vheathen/midal/hardware/pics/perfboard-03.png

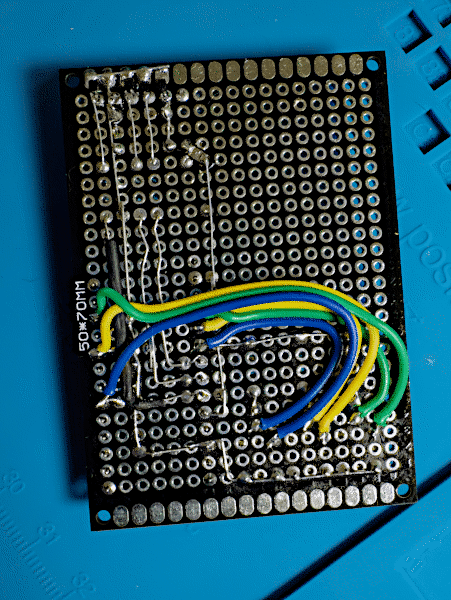
hardware/pics/perfboard-03.png
