vheathen/midal/hardware/pdf/Core board/SCH_Core board_2-PEDAL.pdf

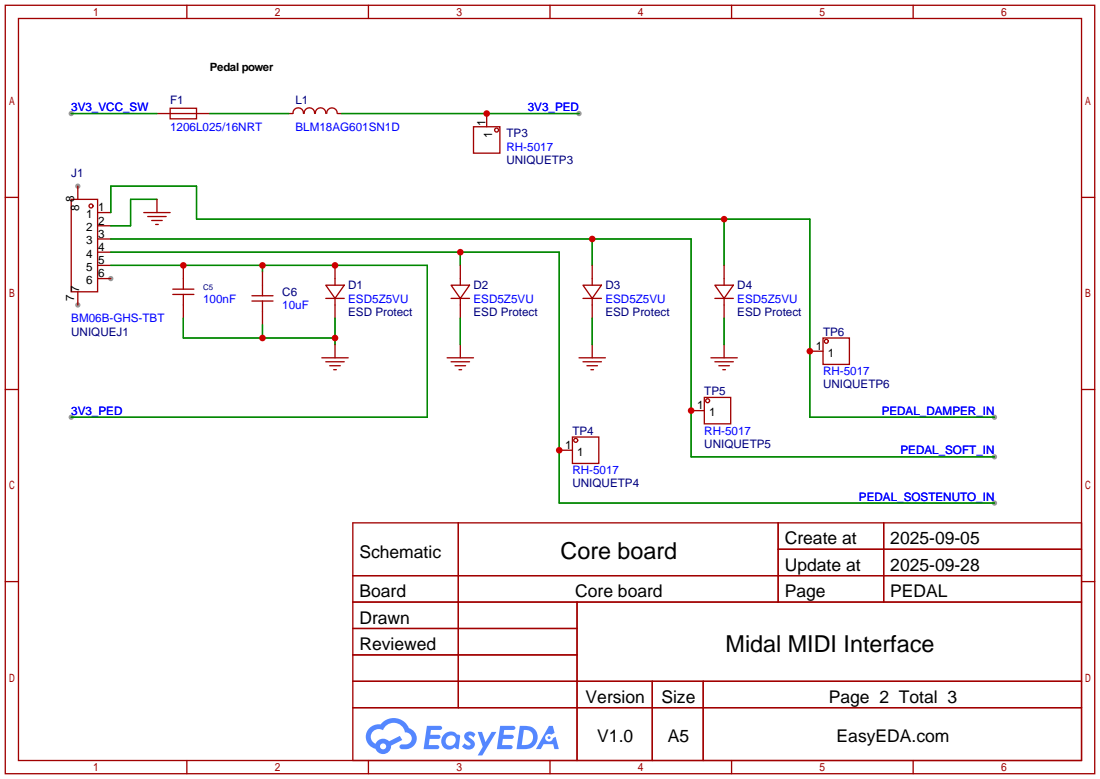
[picture p7: page 1]

Schematic | Core board | Create at | 2025-09-05

Update at | 2025-09-28

Board | Core board | Page | PEDAL
Drawn | | Midal MIDI Interface
Reviewed

Version | Size | Page 2 Total 3
V1.0 | A5 | EasyEDA.com
