vheathen/midal/hardware/pdf/Core board/SCH_Core board_3-MIDI OUT.pdf

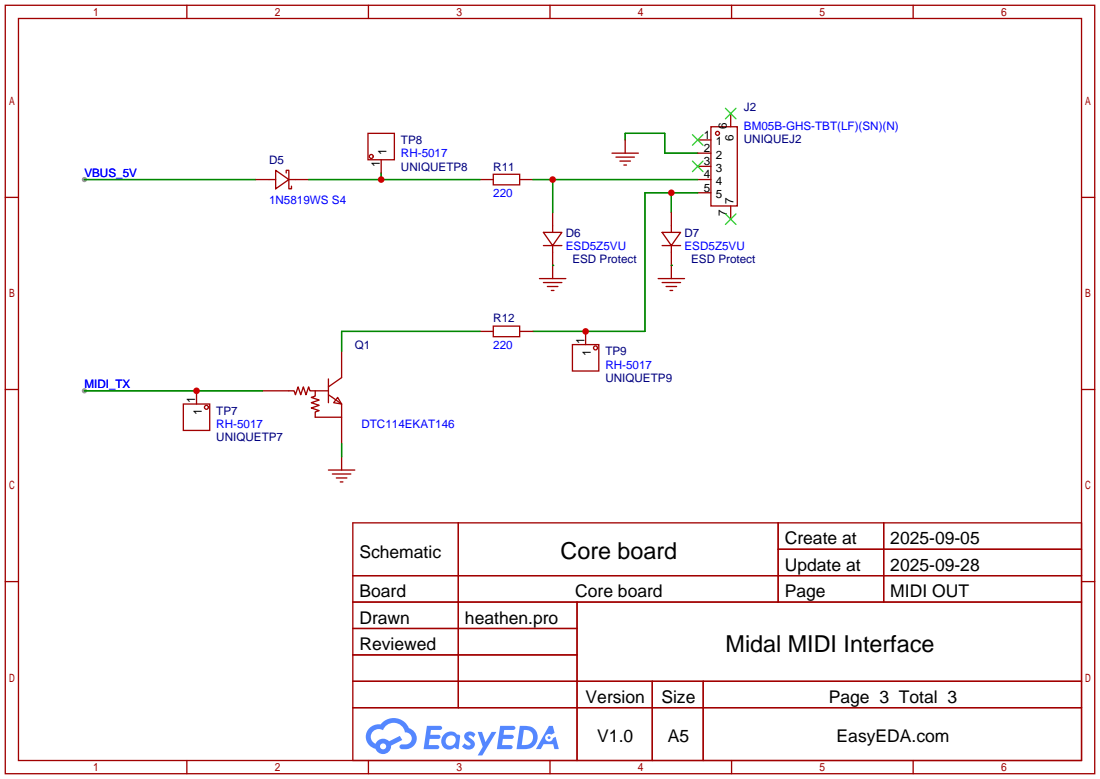
[picture p8: page 1]

Schematic | Core board | Create at | 2025-09-05

Update at | 2025-09-28

Board | Core board | Page | MIDI OUT
Drawn | heathen.pro | Midal MIDI Interface
Reviewed

Version | Size | Page 3 Total 3
V1.0 | A5 | EasyEDA.com
