vheathen/midal/hardware/pdf/Indication/SCH_Indication_1-Indication.pdf

# Indication

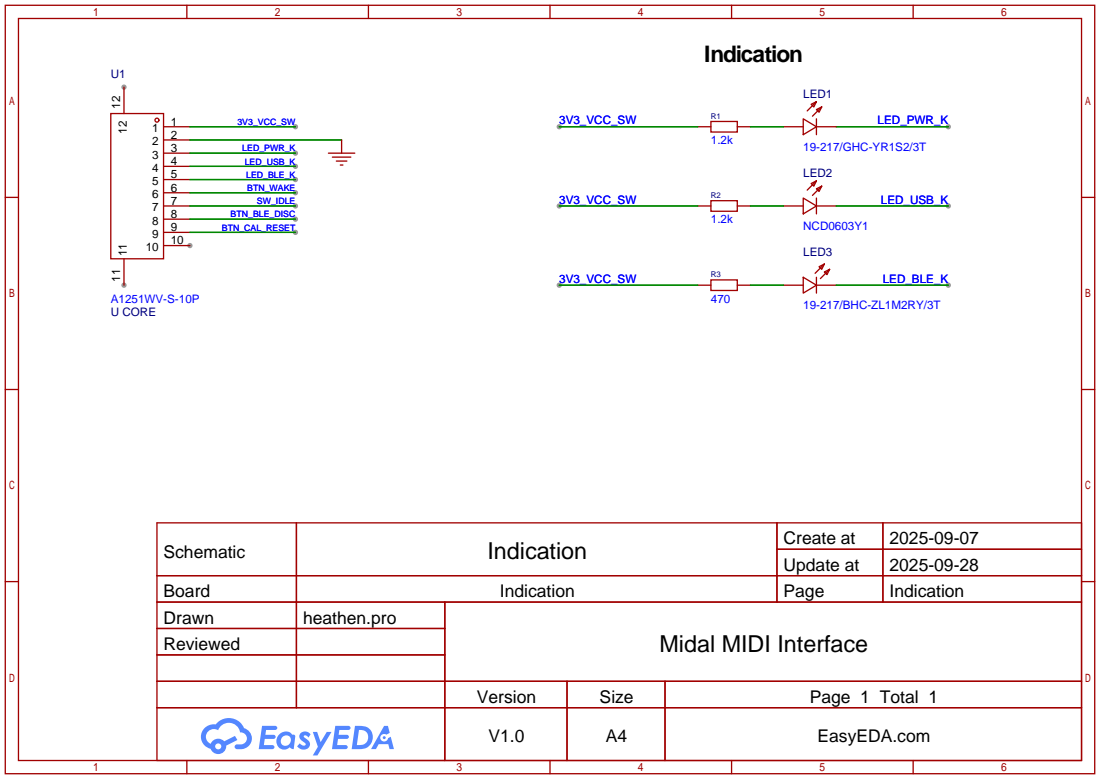
[picture p9: page 1]

Schematic | Indication | Create at | 2025-09-07

Update at | 2025-09-28

Board | Indication | Page | Indication
Drawn | heathen.pro | Midal MIDI Interface
Reviewed

Version | Size | Page 1 Total 1
V1.0 | A4 | EasyEDA.com
