vheathen/midal/(list of files, drawings)

Other design files:
hardware/easyeda/Midal-MIDI-Interface_2025-12-06.epro
