vheathen/midal/(commit log)

2025-09-20 Board related base configs
2025-09-23 One big messy commit with raw ADC pedal readins working
2025-09-24 Pedal filter improvements and pedals run-time calibration
2025-09-24 pedal subsystem refactored: modules renamed, polling timer moved to the reader thread, timer initialization happenes also in the thread itself after start
2025-09-24 Do not route duplicated from pedal sampler
2025-09-24 Allow to invert pedal sensor values (default case for Kawai GFP-3)
    [pedal_filter.c]
2025-09-26 Stable pedal sensors reading without hangs
2025-09-28 Initial hardware design (schematic only yet)
2025-10-16 Migrate to zbus message bus for inter-module communication
    Replaced direct function calls and message queues with Zephyr's zbus
    (message bus) for cleaner, more maintainable inter-module communication.
    Changes:
    - Added zbus configuration to prj.conf
    - Created zbus_channels.{c,h} with midi_event_chan channel
    - Migrated pedal sampler to publish MIDI events to zbus channel
    - Migrated MIDI router to subscribe to zbus channel via MSG_SUBSCRIBER
    - Removed deprecated midi_router_submit() function
    - Router now uses zbus_sub_wait_msg() instead of k_msgq_get()
    Benefits:
    - Loose coupling between pedal sampler and MIDI router
    - Easy to add new observers (buttons, LEDs, calibration)
    - Named channels/obs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
    [pedal_sampler.c, zbus_channels.c, zbus_channels.h]
2025-10-16 Refactor USB MIDI transport to subscribe directly to zbus
    Migrated USB MIDI transport from router dispatch model to direct zbus
    subscription, enabling independent message processing with isolation.
    - Added ZBUS_MSG_SUBSCRIBER_DEFINE(usb_midi_sub) for USB transport
    - Created dedicated usb_midi_thread with its own FIFO queue
    - Transport subscribes directly to midi_event_chan at init
    - Removed dependency on midi_router for message dispatch
    - Updated transport_usb_midi_init() to take no parameters
    - Added sent/dropped statistics tracking
    - No router dispatch overhead - direct pub/sub
    - Independent FIFO queue provides backpressure isolation
    - Transport thread runs independent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
2025-10-16 Remove MIDI router - transports now subscribe directly to zbus
    Eliminated the entire MIDI router layer as it's no longer needed.
    Transports subscribe directly to the midi_event_chan via zbus,
    achieving true pub/sub architecture with zero dispatch overhead.
    - Removed src/midi/midi_router.{c,h} completely
    - Removed router from CMakeLists.txt build
    - Removed router init/start calls from main.c
    - Removed router include from main.c
    - ~250 lines of code eliminated
    - Zero dispatch overhead - direct zbus pub/sub
    - Simpler architecture - no intermediary layer
    - Each transport fully independent with own FIFO
    - Future stats/diagnostics can be separate module
    New architecture:
    Pe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
    [main.c]
2025-10-16 Fix remaining router references in diagnostics
    Removed last references to the deleted MIDI router from heartbeat
    and pedal_reader diagnostic code.
    - heartbeat.c: Removed router stats, simplified to show only USB/BLE ready status
    - pedal_reader.c: Removed router_get_dropped() call from debug logging
    All router code is now completely removed from the codebase.
    Relates to #1
    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
    [heartbeat.c, pedal_reader.c]
2025-10-16 Code style warnings fixed
    [pedal_reader.c]
2025-10-16 Implement real-time priority for USB MIDI - drop old, send fresh
    Changed USB MIDI transport to prioritize fresh messages over old
    queued ones by eliminating retries when buffers are full.
    - Removed retry loop (3 attempts with busy-wait) from safe_send()
    - Drop messages immediately if USB buffers full (-EAGAIN/-ENOSPC)
    - Count drops per-event (not per-message) to avoid double-counting
    - Return error from usb_midi_tx() if either MIDI1 or MIDI2 send fails
    - Transport thread counts one drop per failed event
    - Real-time priority: Fresh pedal data sent immediately
    - No artificial latency from retries (removed 200µs busy-wait)
    - Buffer full = drop old message, not wait for it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
